rskarmarkar/horse-jump/cad/axles_preview.png

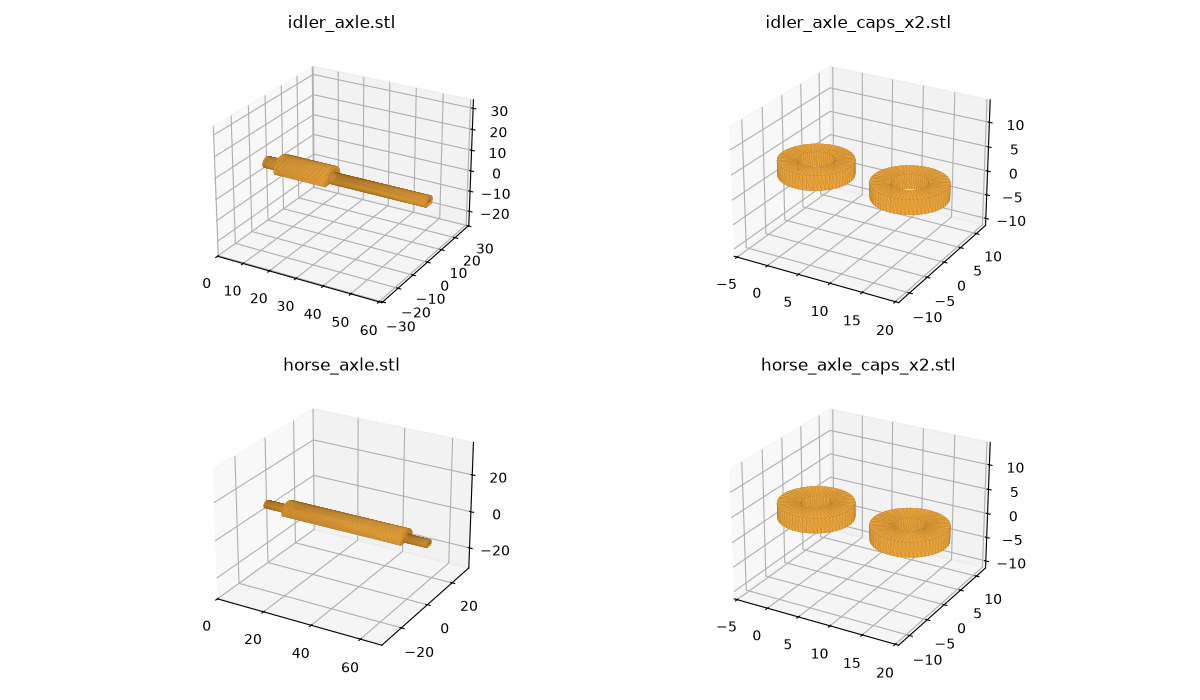
cad/axles_preview.png
