rskarmarkar/horse-jump/cad/brackets_preview.png

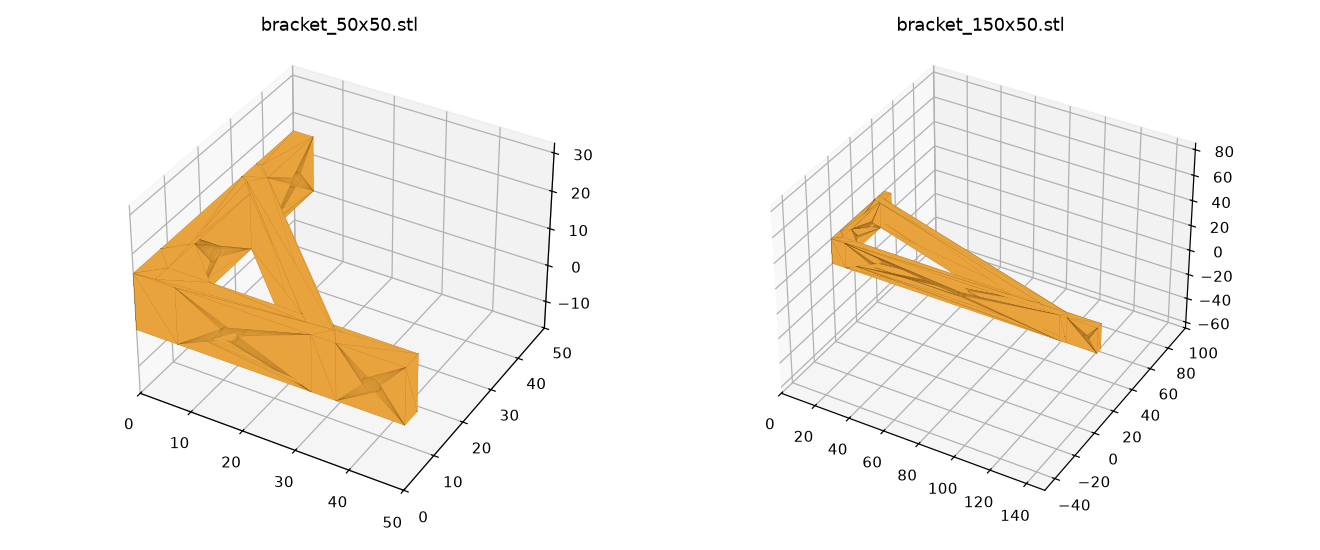
cad/brackets_preview.png
