rskarmarkar/horse-jump/cad/cases_preview.png

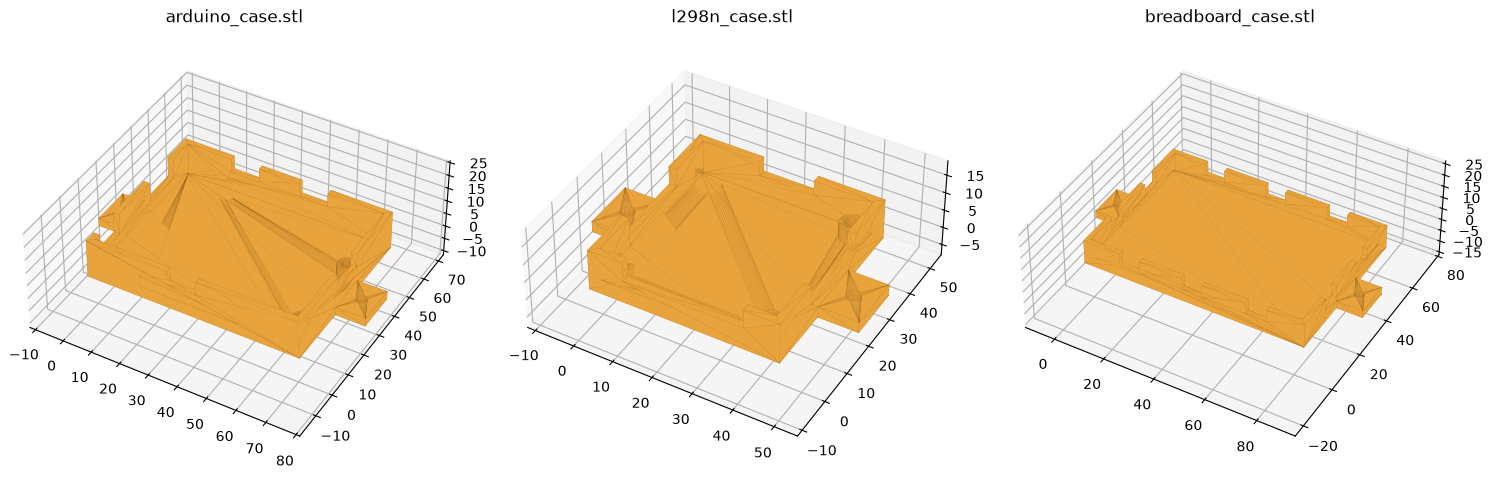
cad/cases_preview.png
