rskarmarkar/horse-jump/cad/crank_preview.png

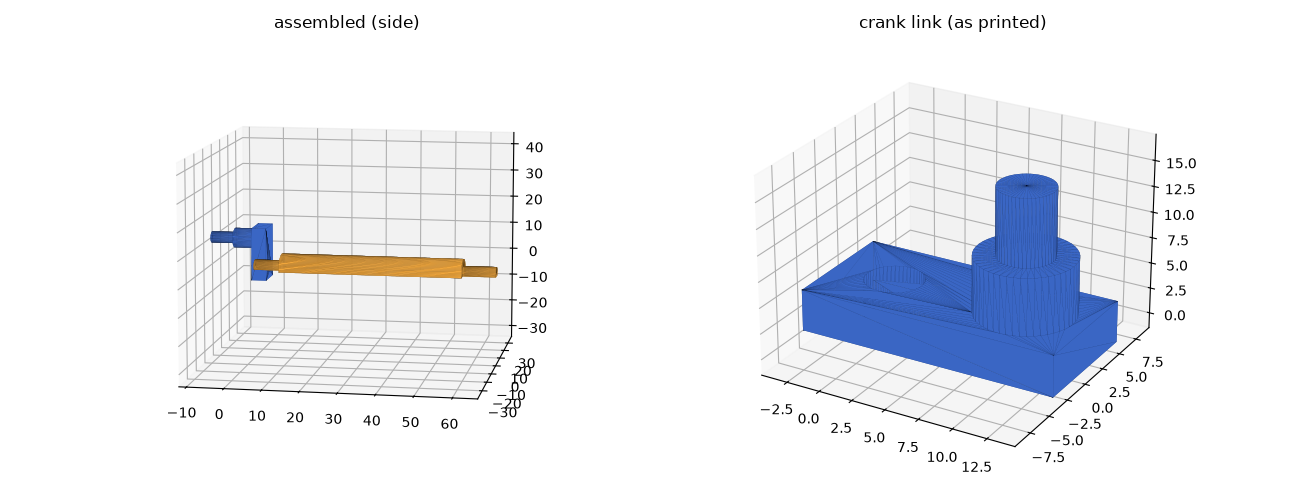
cad/crank_preview.png
