rskarmarkar/horse-jump/cad/preview.png

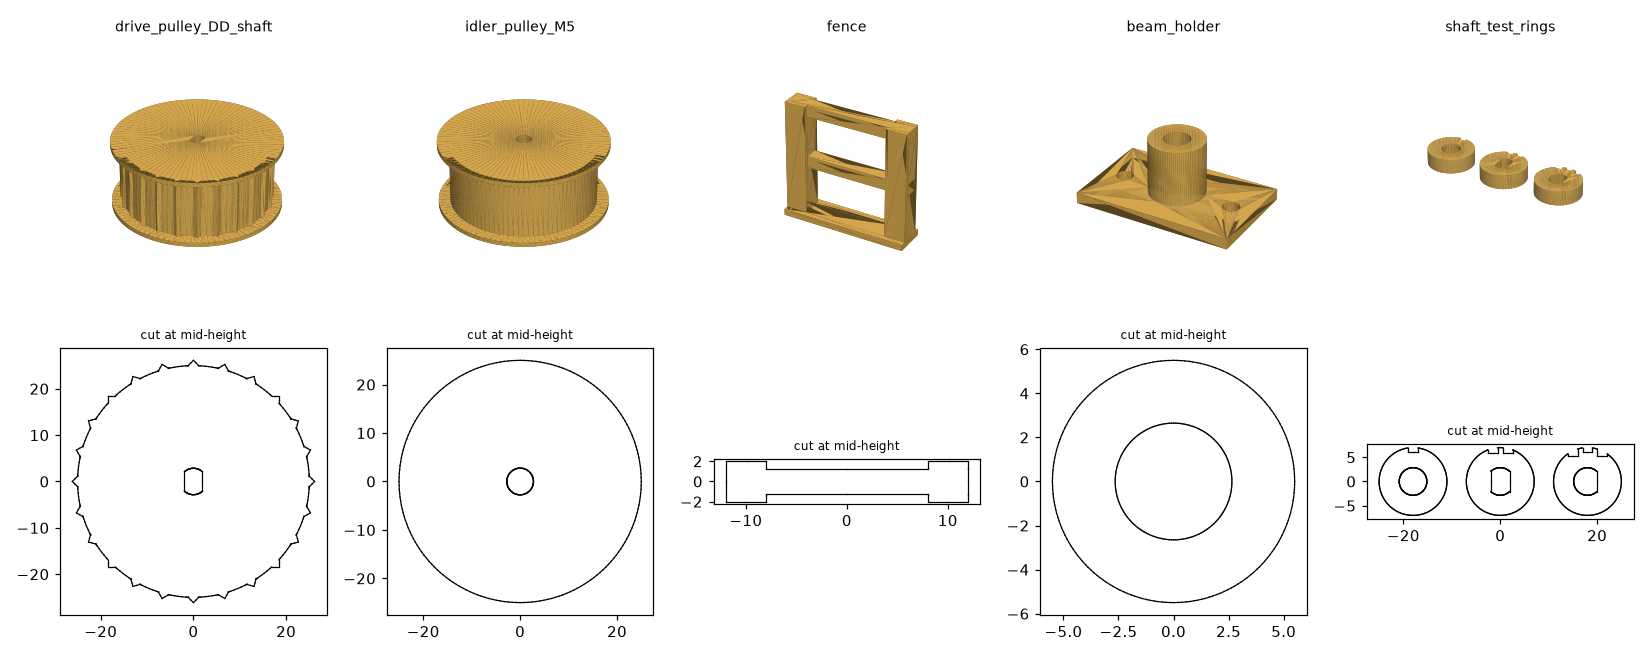
cad/preview.png
