rskarmarkar/horse-jump/cad/pulley_axles_preview.png

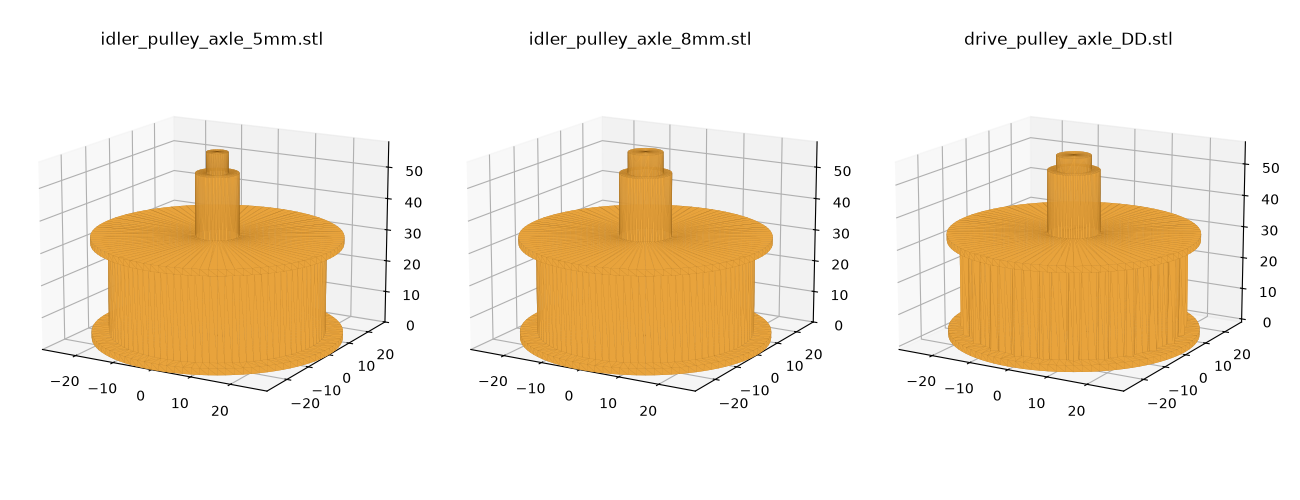
cad/pulley_axles_preview.png
