rskarmarkar/horse-jump/how_it_fits.png

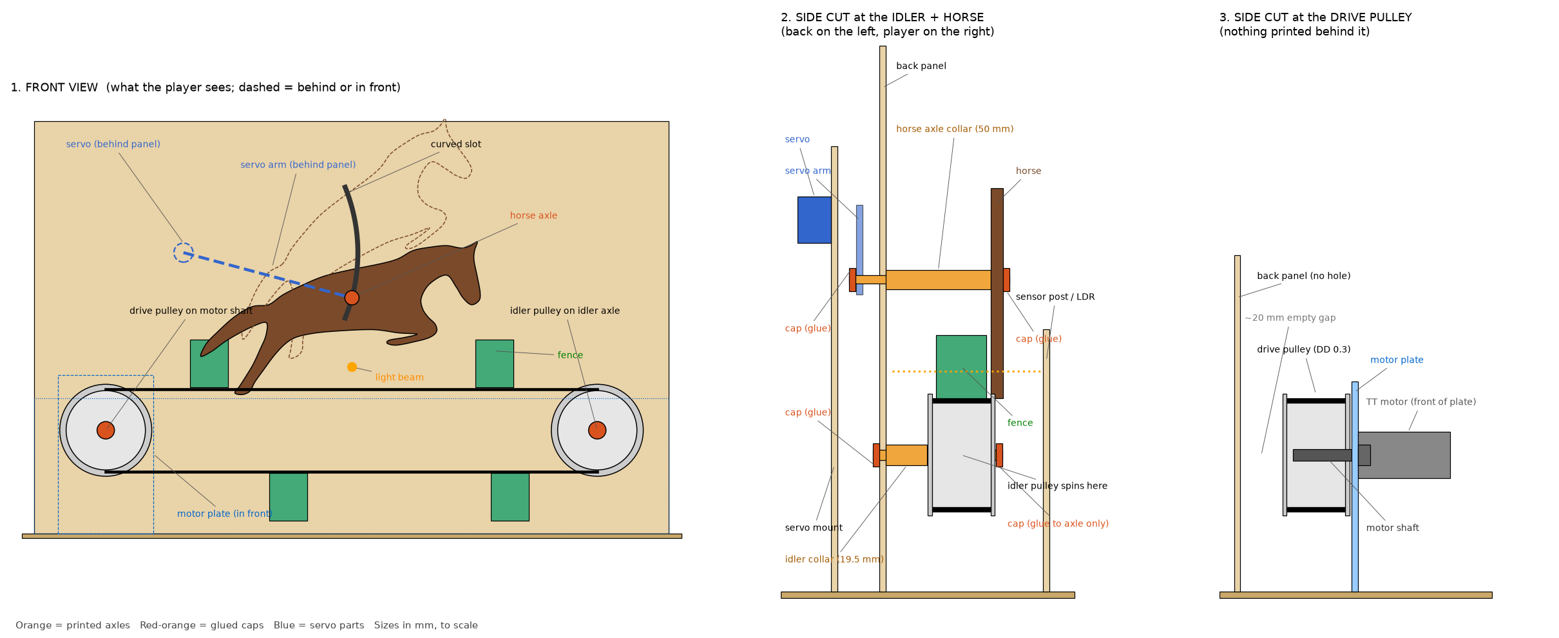
how_it_fits.png
