rskarmarkar/horse-jump/cad/stl/breadboard_case.stl

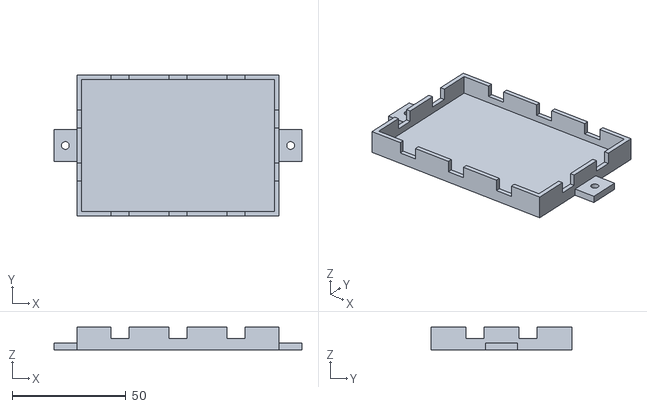
[picture p8: CAD file, 2026-11-12]
cad/stl/breadboard_case.stl
109.0 x 62.0 x 10.0
