rskarmarkar/horse-jump/cad/stl/arduino_case.stl

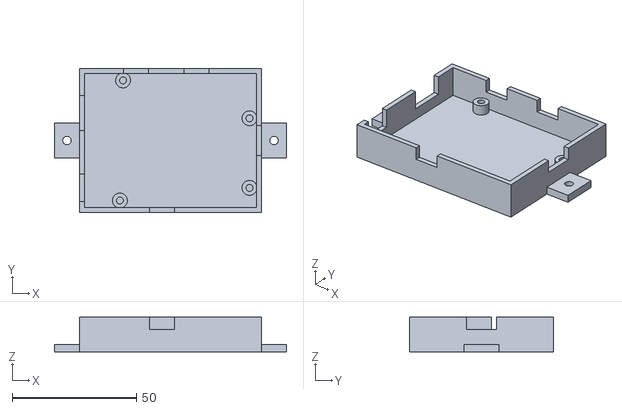
[picture p9: CAD file, 2026-11-12]
cad/stl/arduino_case.stl
93.2 x 57.9 x 14.0
