rskarmarkar/horse-jump/cad/stl/l298n_case.stl

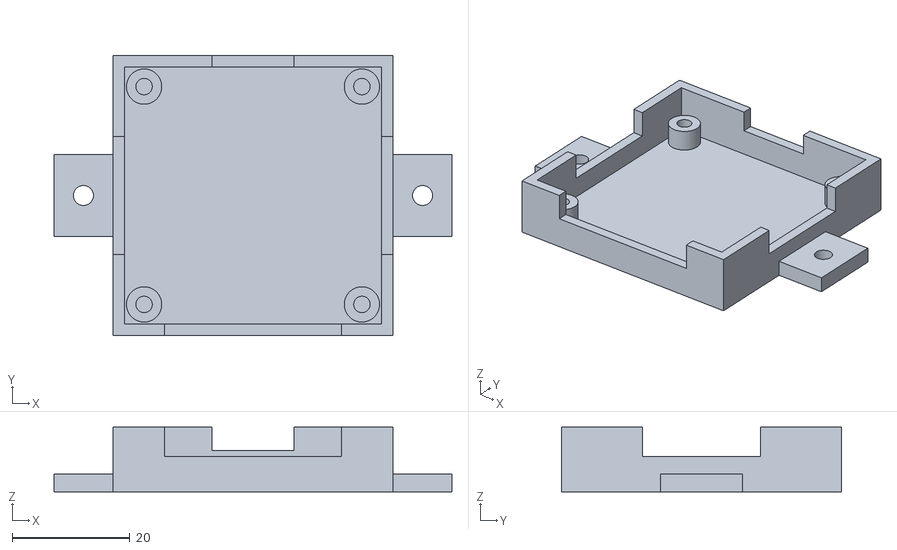
[picture p10: CAD file, 2026-11-12]
cad/stl/l298n_case.stl
67.6 x 47.6 x 11.0
