rskarmarkar/horse-jump/cad/stl/idler_axle_cap_5mm.stl

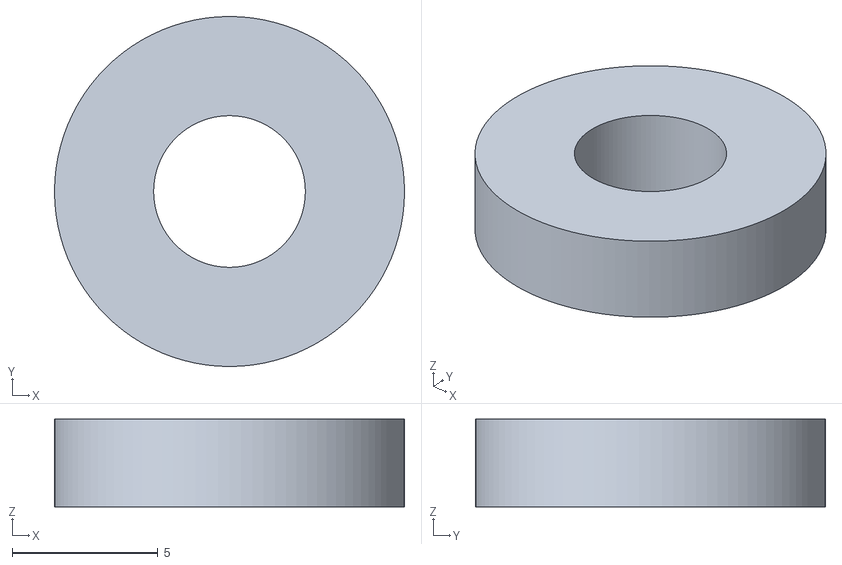
[picture p11: CAD file, 2026-11-12]
cad/stl/idler_axle_cap_5mm.stl
12.0 x 12.0 x 3.00
