rskarmarkar/horse-jump/cad/stl/idler_pulley_tall_banks.stl

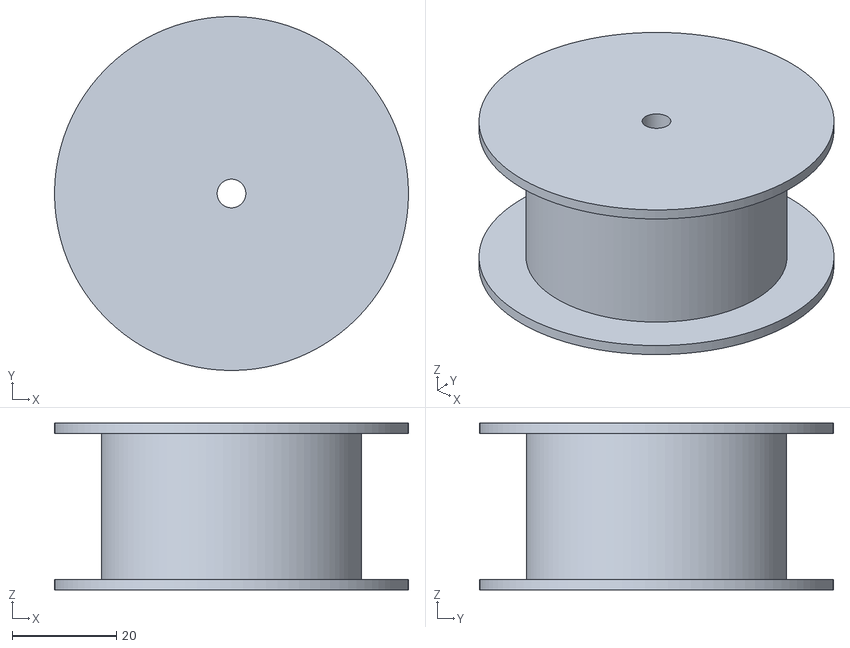
[picture p12: CAD file, 2026-11-12]
cad/stl/idler_pulley_tall_banks.stl
68.0 x 68.0 x 32.0
