rskarmarkar/horse-jump/cad/stl/idler_pulley_axle_8mm.stl

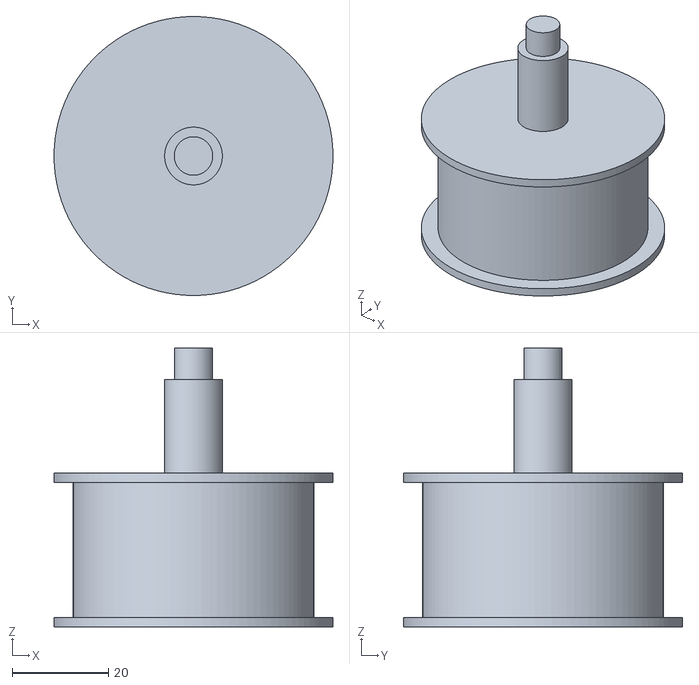
[picture p13: CAD file, 2026-11-12]
cad/stl/idler_pulley_axle_8mm.stl
58.0 x 58.0 x 58.0
