rskarmarkar/horse-jump/cad/stl/shaft_test_ring_DD.stl

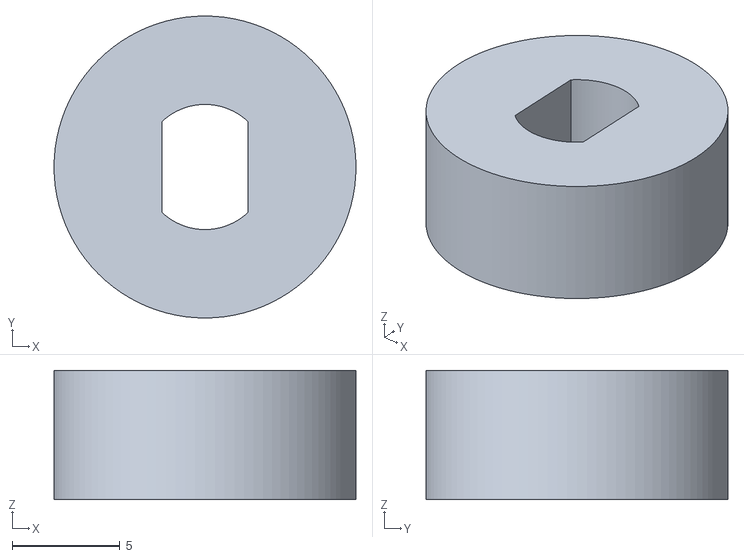
[picture p14: CAD file, 2026-11-12]
cad/stl/shaft_test_ring_DD.stl
14.0 x 14.0 x 6.00
