rskarmarkar/horse-jump/cad/stl/fence.stl

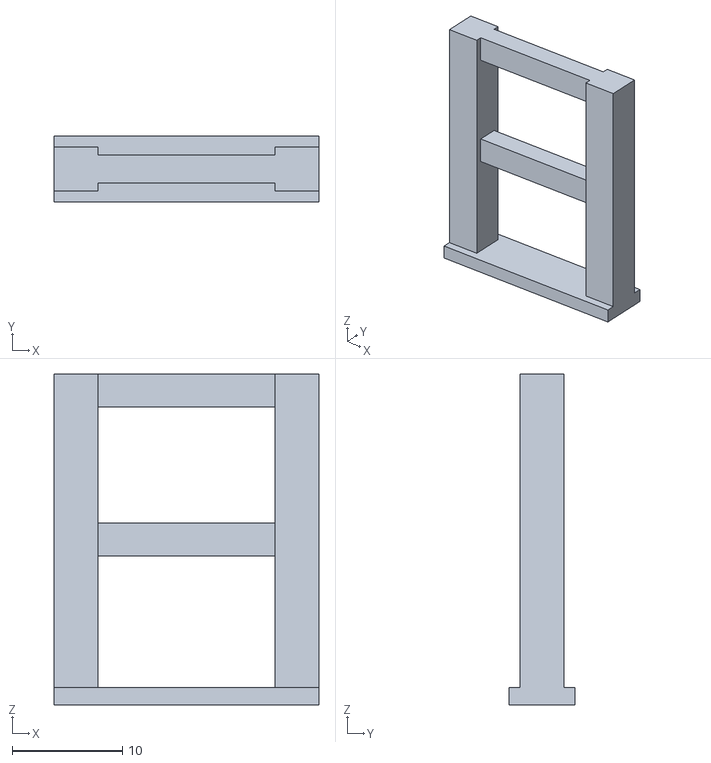
[picture p15: CAD file, 2026-11-12]
cad/stl/fence.stl
24.0 x 6.00 x 30.0
