rskarmarkar/horse-jump/cad/stl/bracket_30x30_5mm_noholes.stl

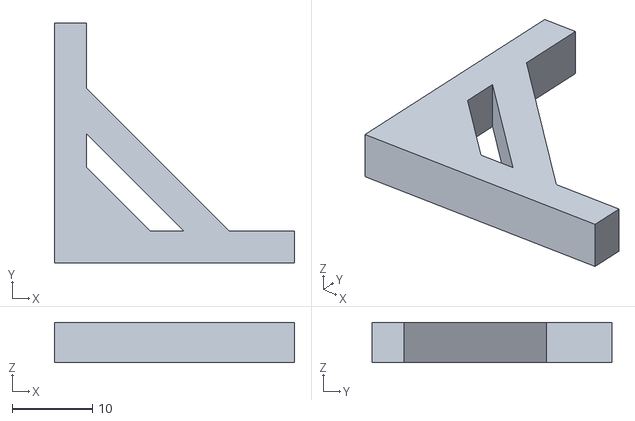
[picture p16: CAD file, 2026-11-12]
cad/stl/bracket_30x30_5mm_noholes.stl
30.0 x 30.0 x 5.00
