rskarmarkar/horse-jump/cad/stl/idler_pulley_M5.stl

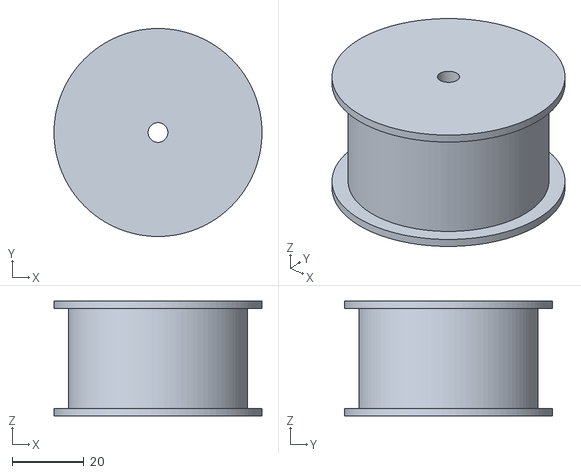
[picture p17: CAD file, 2026-11-12]
cad/stl/idler_pulley_M5.stl
58.0 x 58.0 x 32.0
