rskarmarkar/horse-jump/cad/stl/beam_holder.stl

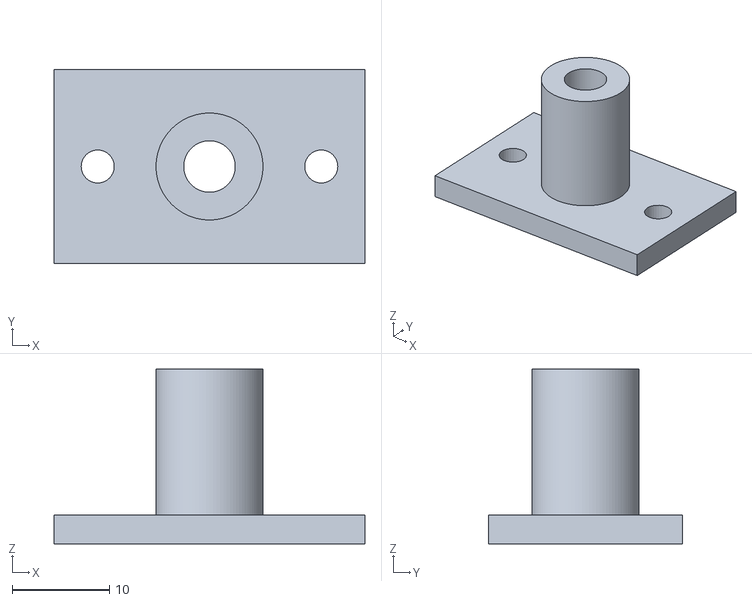
[picture p18: CAD file, 2026-11-12]
cad/stl/beam_holder.stl
32.0 x 20.0 x 18.0
