rskarmarkar/horse-jump/cad/stl/shaft_test_rings.stl

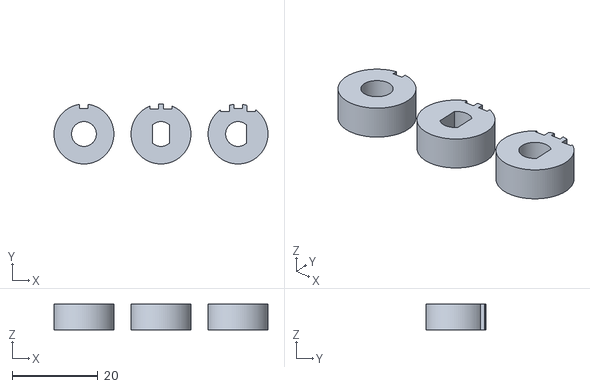
[picture p19: CAD file, 2026-11-12]
cad/stl/shaft_test_rings.stl
50.0 x 14.0 x 6.00
