rskarmarkar/horse-jump/cad/stl/idler_axle_caps_x2.stl

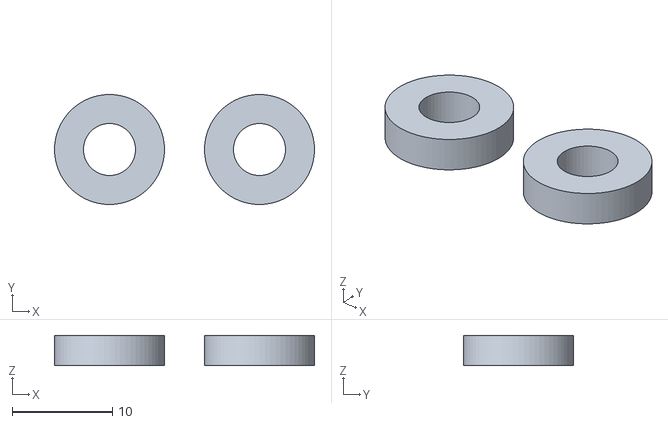
[picture p21: CAD file, 2026-11-12]
cad/stl/idler_axle_caps_x2.stl
26.0 x 11.0 x 3.00
