rskarmarkar/horse-jump/cad/stl/horse_axle_crank_link_15mm.stl

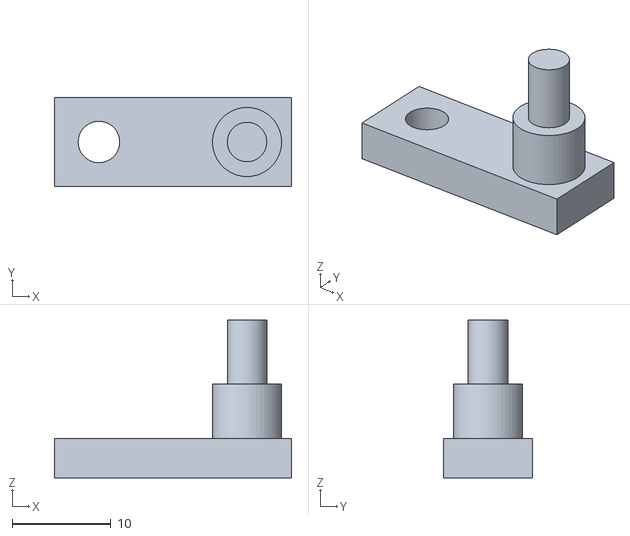
[picture p22: CAD file, 2026-11-12]
cad/stl/horse_axle_crank_link_15mm.stl
24.0 x 9.00 x 16.0
