rskarmarkar/horse-jump/cad/stl/bracket_50x50.stl

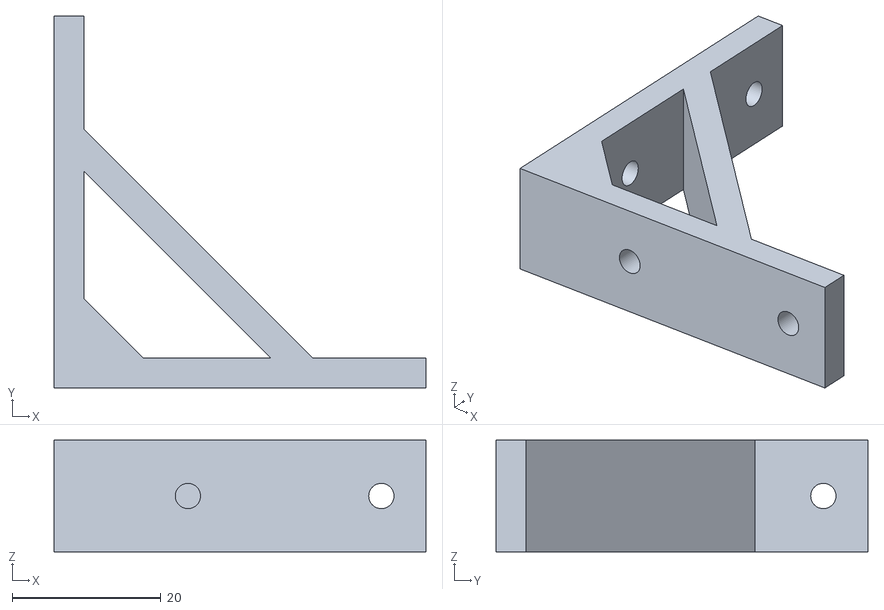
[picture p23: CAD file, 2026-11-12]
cad/stl/bracket_50x50.stl
50.0 x 50.0 x 15.0
