rskarmarkar/horse-jump/cad/stl/idler_axle_cap_8mm.stl

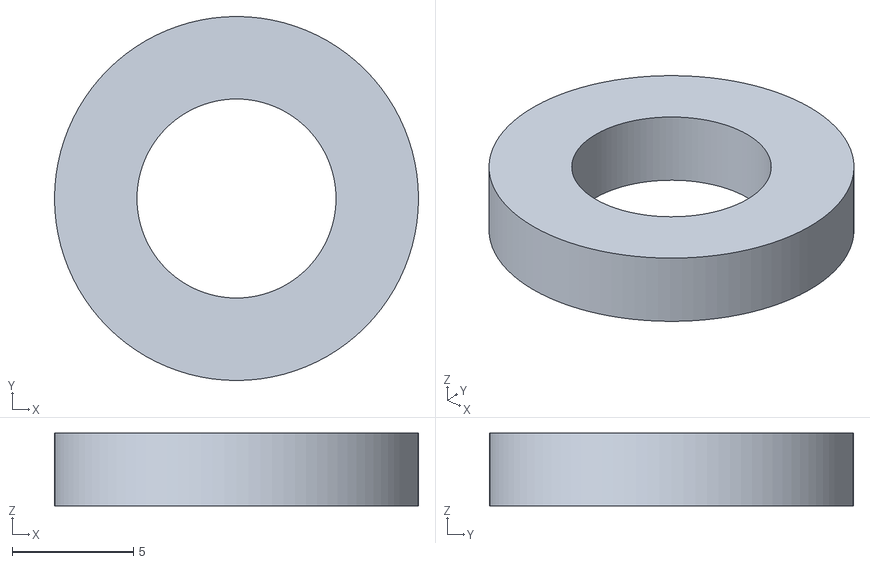
[picture p25: CAD file, 2026-11-12]
cad/stl/idler_axle_cap_8mm.stl
15.0 x 15.0 x 3.00
