rskarmarkar/horse-jump/cad/stl/drive_pulley_D_shaft.stl

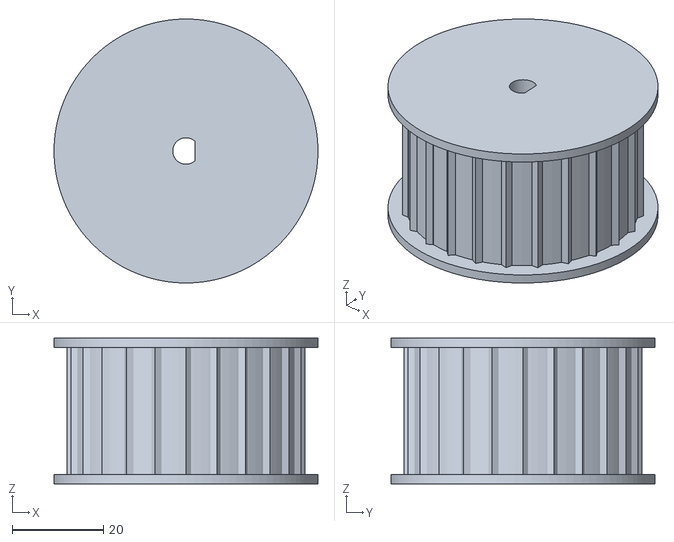
[picture p26: CAD file, 2026-11-12]
cad/stl/drive_pulley_D_shaft.stl
58.0 x 58.0 x 32.0
