rskarmarkar/horse-jump/cad/stl/drive_pulley_axle_DD.stl

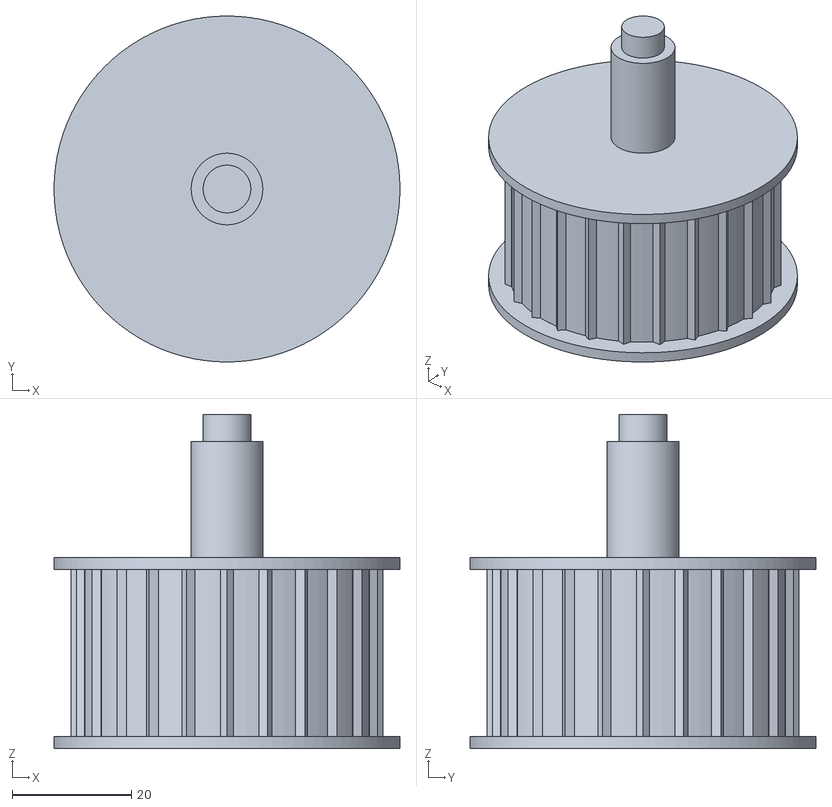
[picture p27: CAD file, 2026-11-12]
cad/stl/drive_pulley_axle_DD.stl
58.0 x 58.0 x 56.0
