rskarmarkar/horse-jump/cad/stl/idler_axle.stl

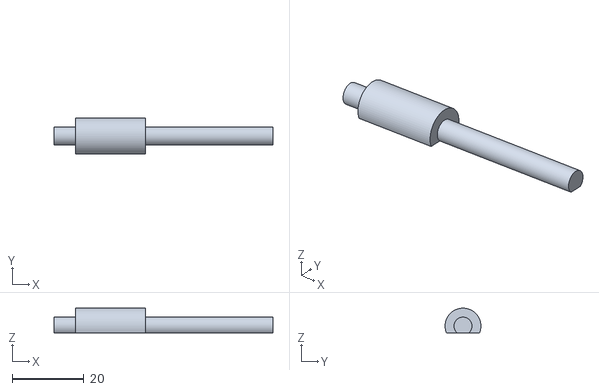
[picture p28: CAD file, 2026-11-12]
cad/stl/idler_axle.stl
61.0 x 10.0 x 6.90
