rskarmarkar/horse-jump/cad/stl/bracket_150x50.stl

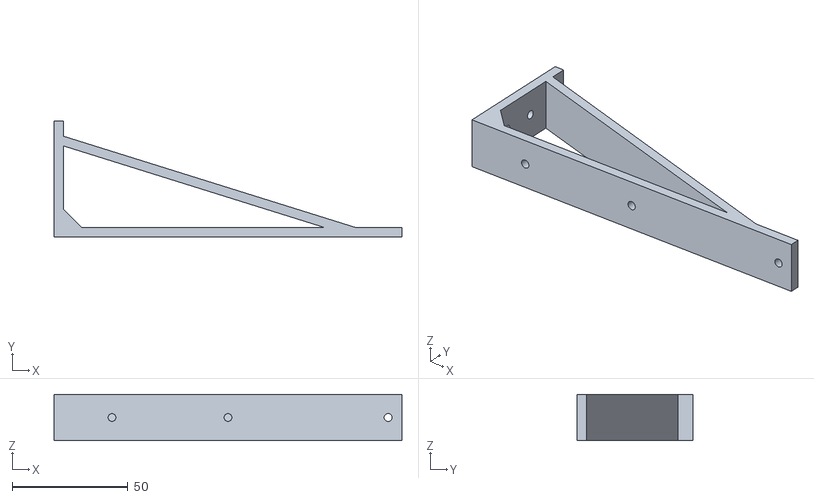
[picture p29: CAD file, 2026-11-12]
cad/stl/bracket_150x50.stl
150.0 x 50.0 x 20.0
