rskarmarkar/horse-jump/cad/stl/horse_axle_crank_link.stl

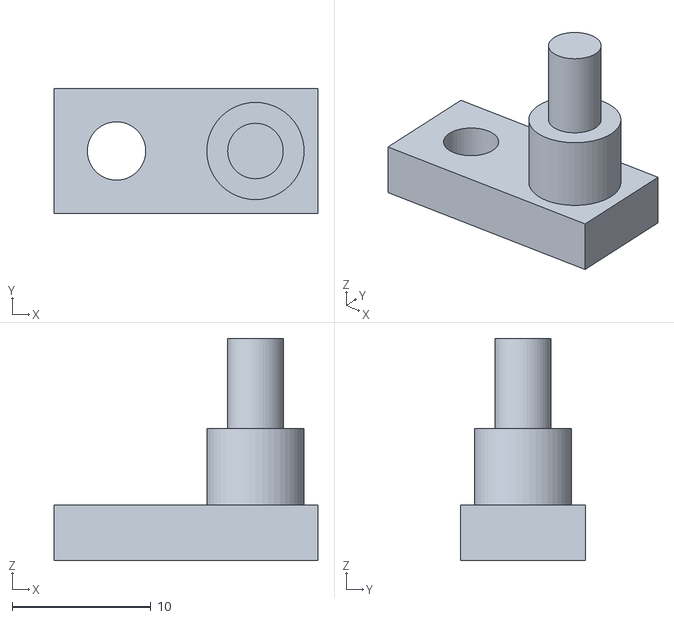
[picture p30: CAD file, 2026-11-12]
cad/stl/horse_axle_crank_link.stl
19.0 x 9.00 x 16.0
