rskarmarkar/horse-jump/cad/stl/horse_axle.stl

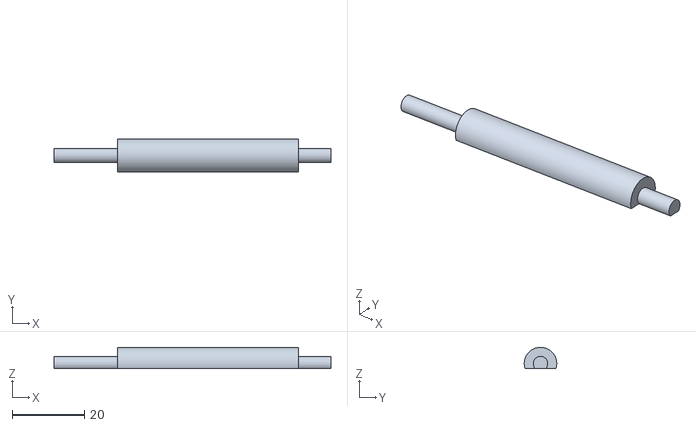
[picture p31: CAD file, 2026-11-12]
cad/stl/horse_axle.stl
76.5 x 9.00 x 5.90
