rskarmarkar/horse-jump/cad/stl/bracket_50x50_15mm_noholes.stl

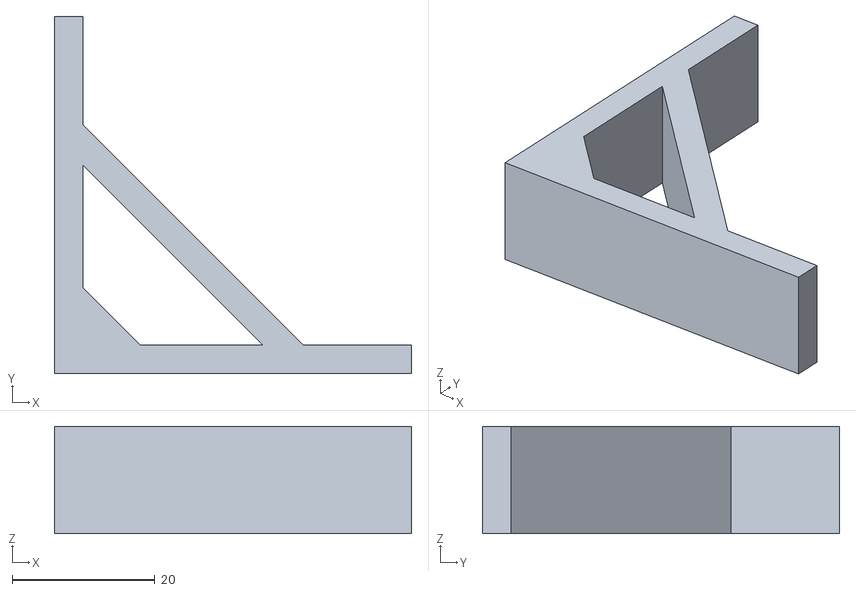
[picture p32: CAD file, 2026-11-12]
cad/stl/bracket_50x50_15mm_noholes.stl
50.0 x 50.0 x 15.0
