rskarmarkar/horse-jump/cad/stl/fences_x4.stl

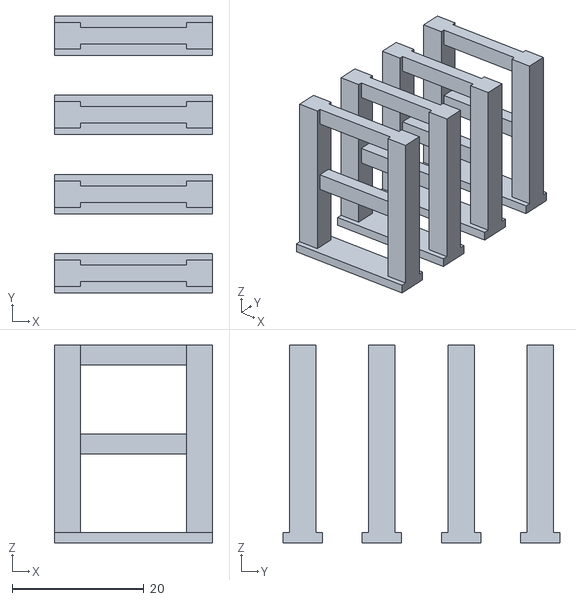
[picture p33: CAD file, 2026-11-12]
cad/stl/fences_x4.stl
24.0 x 42.0 x 30.0
