rskarmarkar/horse-jump/(list of files, cad)

Other CAD files:
cad/stl/drive_pulley_DD_shaft.stl
cad/stl/shaft_test_rings_DD_0.3-0.5.stl
cad/stl/drive_pulley_round_shaft.stl
