rskarmarkar/horse-jump/laser/assembly_preview.png

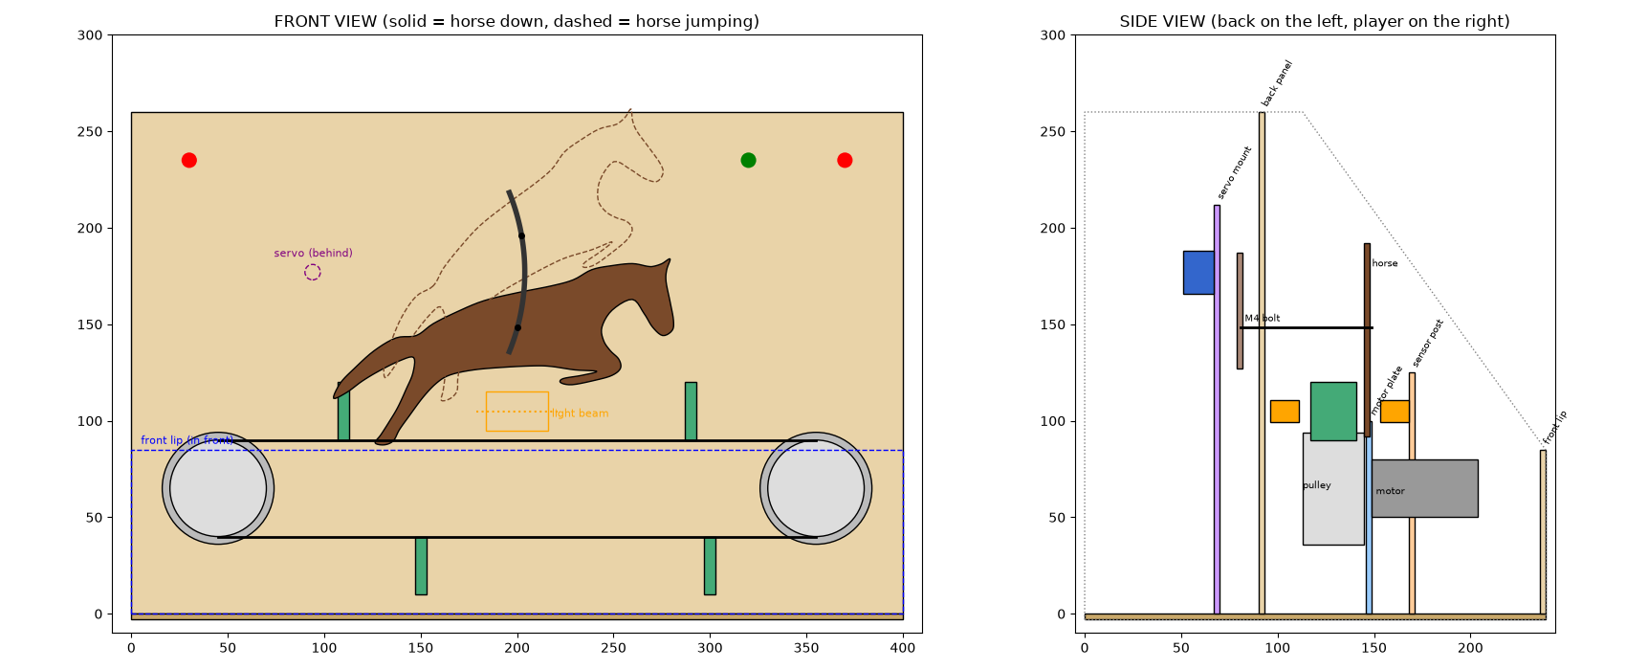
laser/assembly_preview.png
