rskarmarkar/horse-jump/(commit log)

2026-11-12 Horse Jump: p5 + ml5 hand-raise game, Arduino sketch, printed and laser-cut parts
    [beam_holder.stl, bracket_150x50.stl, bracket_30x30_5mm_noholes.stl, bracket_50x50.stl, bracket_50x50_15mm_noholes.stl, drive_pulley_DD_shaft.stl, drive_pulley_D_shaft.stl, drive_pulley_axle_DD.stl]
2026-11-12 Redesign the p5 interface: rounded camera view, score and hands cards, start ring, crash screen
2026-11-12 Add printed trays for the Arduino, L298N and breadboard
    [arduino_case.stl, breadboard_case.stl, l298n_case.stl]
2026-11-12 Breadboard case: 85 x 58 mm pocket
    [breadboard_case.stl]
2026-11-12 Wire the motor to L298N channel B (OUT3/OUT4, ENB/IN3/IN4)
2026-11-12 Raise servo rest angle to 13 so it doesn't stall against the slot end
    [horse_jump.ino]
2026-11-12 Add SERVO_REVERSED so the horse jumps up instead of down
2026-11-12 Revert "Add SERVO_REVERSED so the horse jumps up instead of down"
    This reverts commit b11ff01f944dc813af82afbab27a2238436d8aa9.
    [horse_jump.ino]
2026-11-12 Servo back to the original working setup: rest 20, up 45, normal direction
2026-11-12 Servo rest 5° lower (15)
2026-11-12 Servo rest back to the original 20
